Josh-Ramsey/EE463-Hardware-Project/Simulation_Report/ Block_Diagram.png

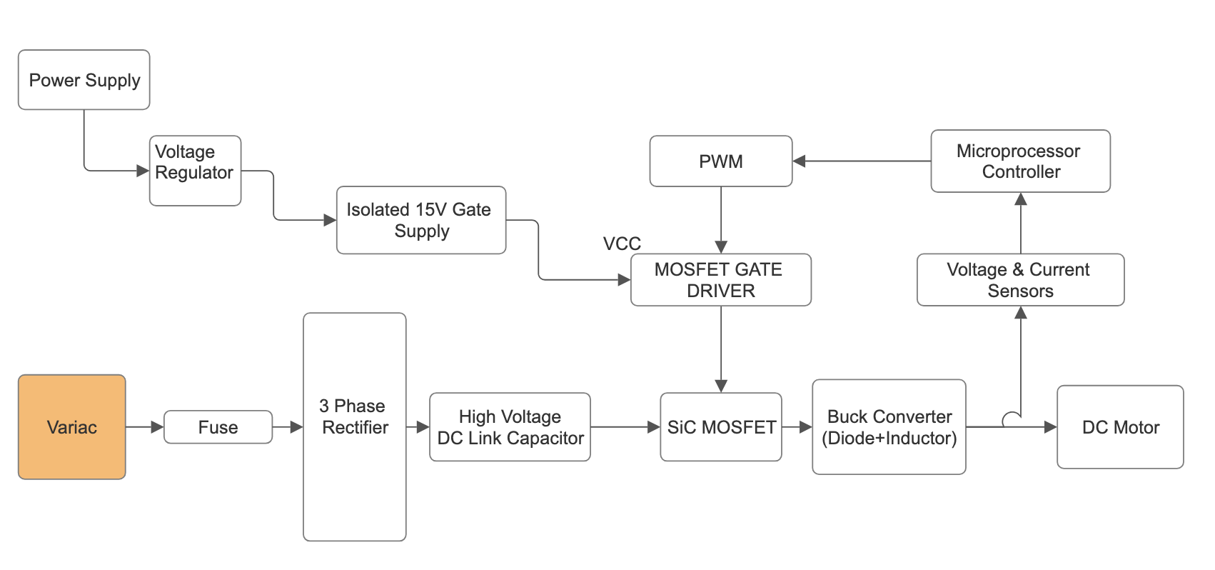
Simulation_Report/ Block_Diagram.png
