Josh-Ramsey/EE463-Hardware-Project/Simulation_Report/Circuit_Topology.jpeg

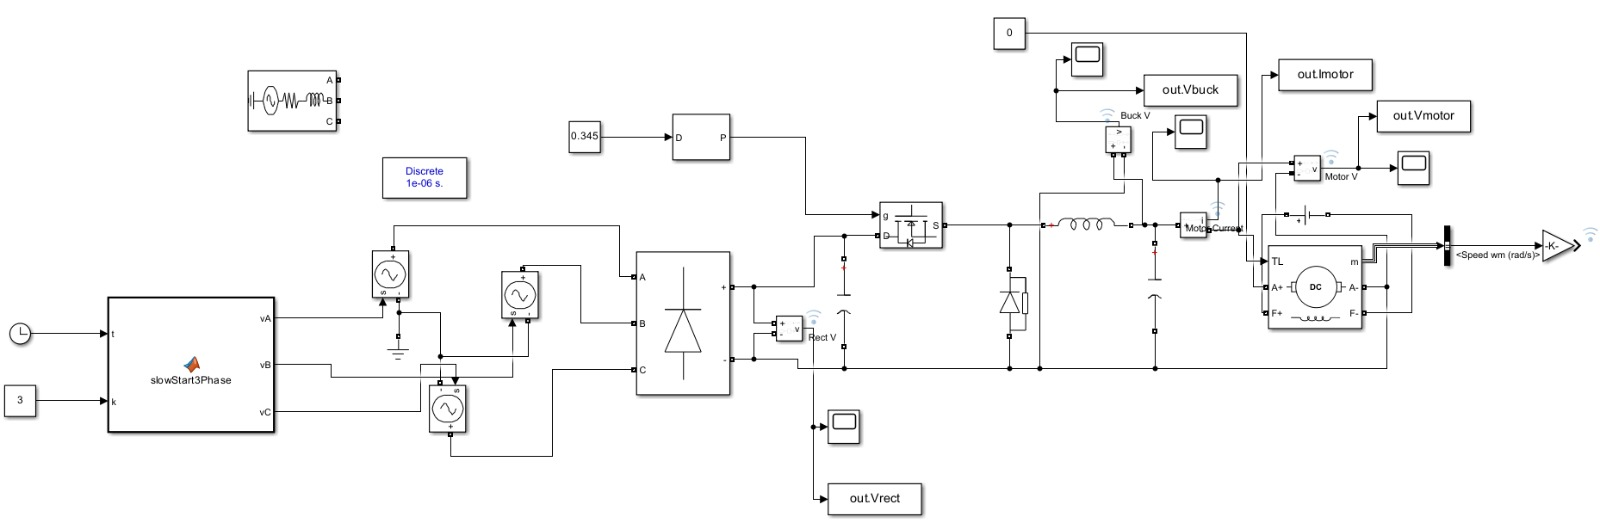
Simulation_Report/Circuit_Topology.jpeg
