Josh-Ramsey/EE463-Hardware-Project/Simulation_Report/Control_Loop_Block_Diagram.png

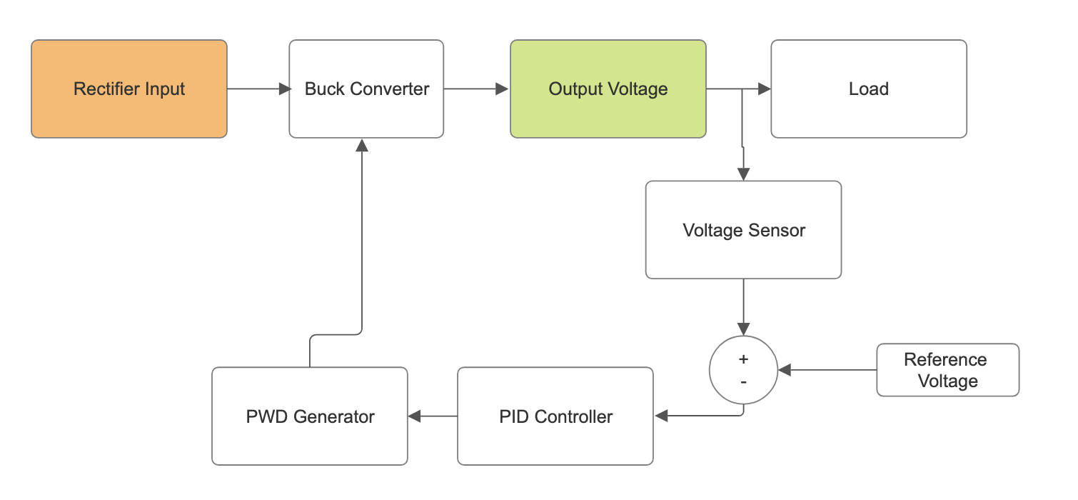
Simulation_Report/Control_Loop_Block_Diagram.png
