Josh-Ramsey/EE463-Hardware-Project/Simulation_Report/motor_current.png

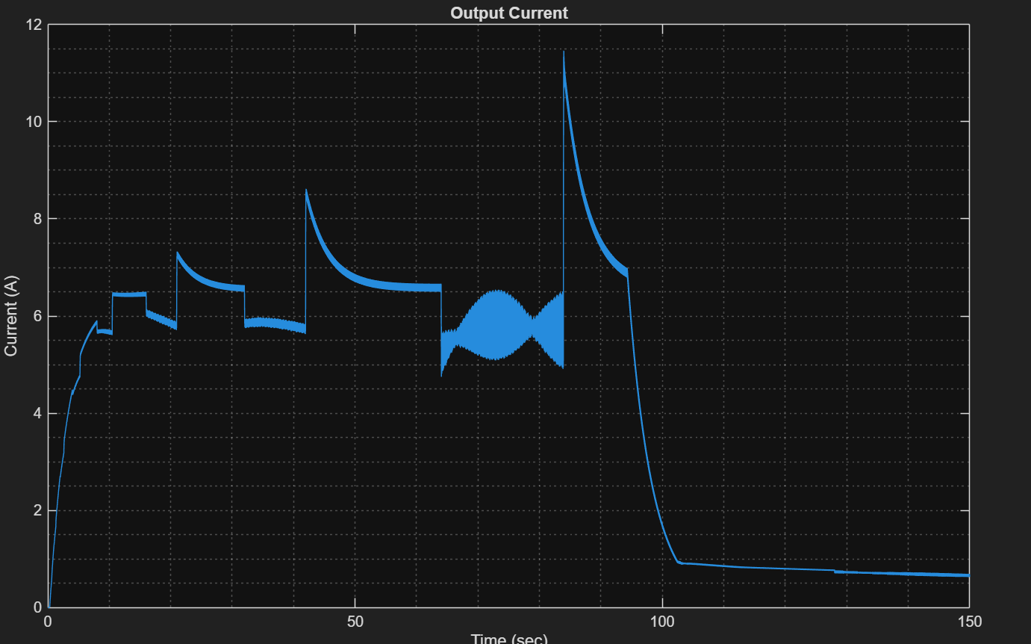
Simulation_Report/motor_current.png
