Josh-Ramsey/EE463-Hardware-Project/Simulation_Report/motor_voltage.png

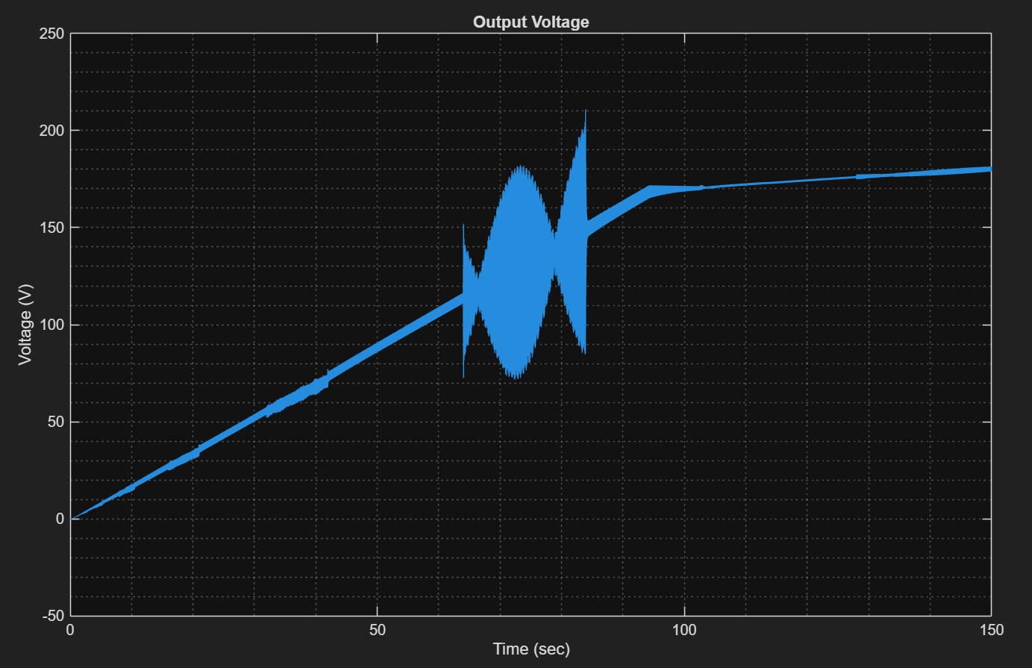
Simulation_Report/motor_voltage.png
