Josh-Ramsey/EE463-Hardware-Project/Simulation_Report/rect_voltage.png

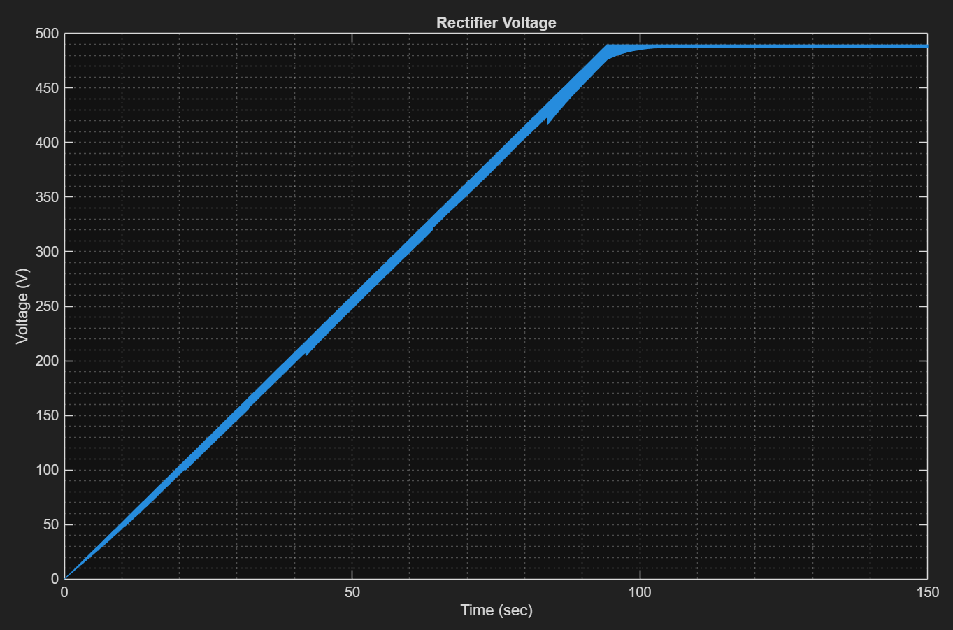
Simulation_Report/rect_voltage.png
