Josh-Ramsey/EE463-Hardware-Project/Circuit_Diagram.kicad_sch

## KiCad design Circuit_Diagram.kicad_sch (2025-12-30)

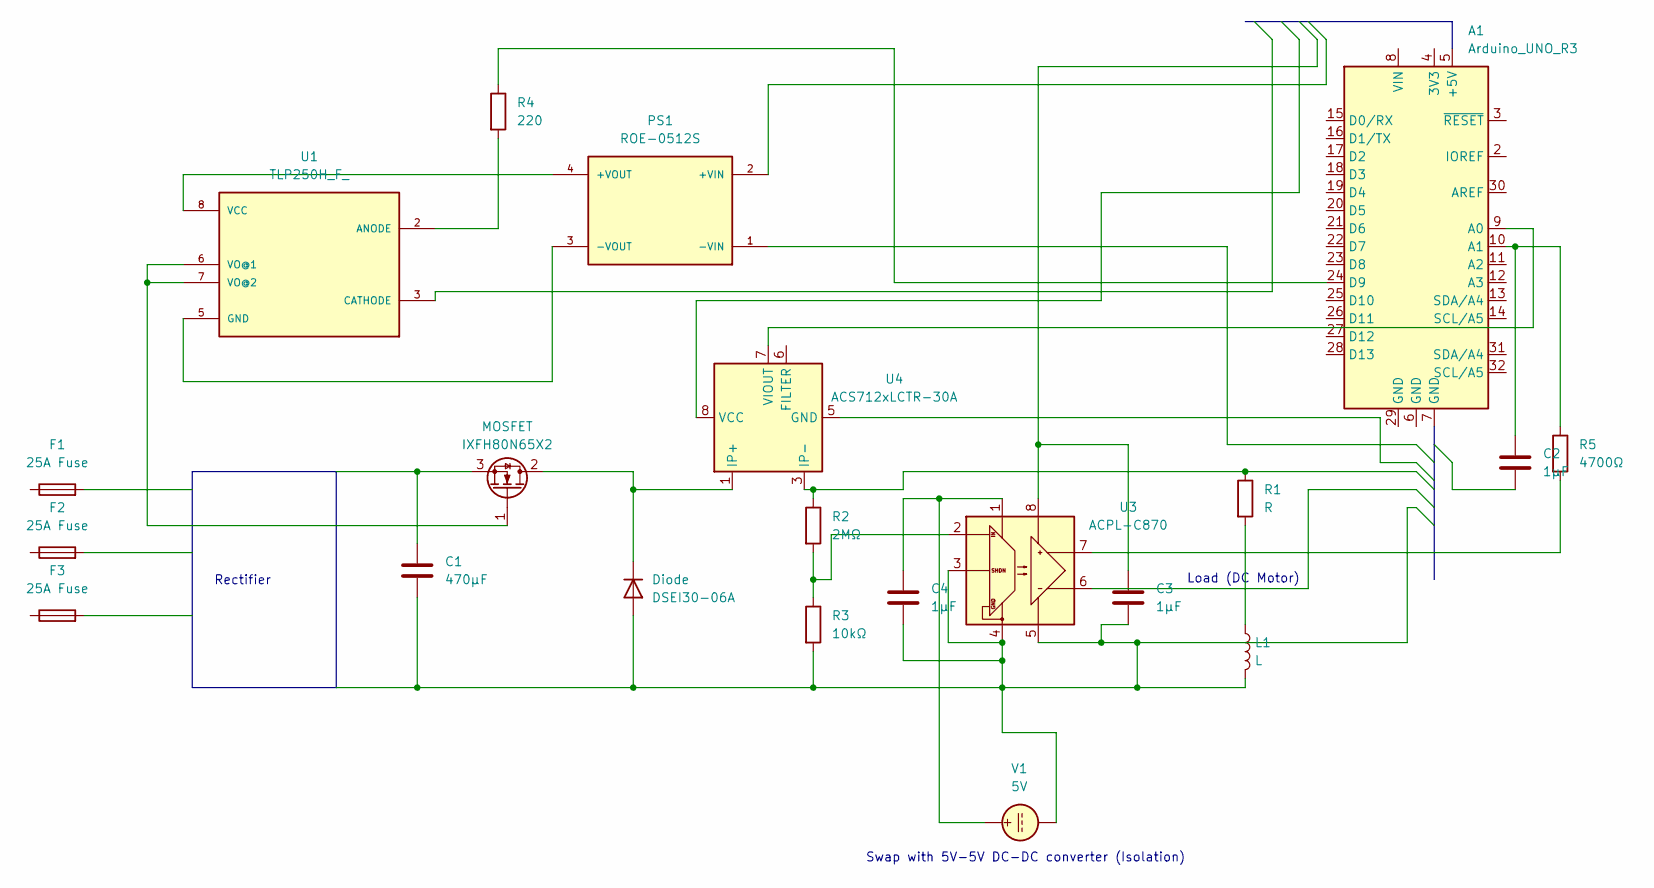
[picture p29: schematic Circuit_Diagram.kicad_sch]

Parts:
A1: Arduino_UNO_R3
C1: 470μF
C2, C3, C4: 1μF
Diode: DSEI30-06A
F1, F2, F3: 25A Fuse
L1: L
MOSFET: IXFH80N65X2
PS1: ROE-0512S; CONV_ROE-0512S; PARTREV 5
R1: R
R2: 2MΩ
R3: 10kΩ
R4: 220
R5: 4700Ω
U1: TLP250H_F_; DIP1016W50P254L966H380Q8P
U3: ACPL-C870; SSO-8_6.8x5.9mm_P1.27mm_Clearance8mm
U4: ACS712xLCTR-30A; SOIC-8_3.9x4.9mm_P1.27mm
V1: 5V

Connections:
unnamed: A1.9 (A0), U4.7 (VIOUT)
unnamed: A1.10 (A1), C2.1, R5.1
unnamed: A1.24 (D9), R4.1
unnamed: C1.1, MOSFET.3 (S)
unnamed: C1.2, C3.2, C4.2, Diode.2 (A), L1.2, R3.2, U3.3 (IN-), U3.4 (GND1), U3.5 (GND2), V1.2
unnamed: C3.1, U3.8 (VDD2)
unnamed: C4.1, U3.1 (VDD1), V1.1
unnamed: Diode.1 (K), MOSFET.2 (D), U4.1 (IP+), U4.2 (IP+)
unnamed: L1.1, R1.2
unnamed: MOSFET.1 (G), U1.6 (VO@1), U1.7 (VO@2)
unnamed: PS1.3 (-VOUT), U1.5 (GND)
unnamed: PS1.4 (+VOUT), U1.8 (VCC)
unnamed: R1.1, R2.1, U4.3 (IP-), U4.4 (IP-)
unnamed: R2.2, R3.1, U3.2 (IN)
unnamed: R4.2, U1.2 (ANODE)
unnamed: R5.2, U3.7 (OUT+)

Notes on the sheet:
Rectifier
Load (DC Motor)
Swap with 5V-5V DC-DC converter (Isolation)
