Josh-Ramsey/EE463-Hardware-Project/(commit log)

2025-12-02 Updated Basic Model of Rectifier+Buck Converter with Resistive Load.
2025-12-02 Updated basic model. Rectifier and Buck converter giving desired outputs
2025-12-05 Circuit Topology uploaded
2025-12-05 Basic Voltage Control Loop Block Diagram Created
2025-12-08 Working Open Loop Model for Rectifier+Buck Converter. Load Simulated
    Component values open to change
2025-12-29 Circuit diagram for Converter+Control Loops
    [Circuit_Diagram.kicad_sch]
2025-12-29 Initial deisgn of Arduino control in simulink. Needs tuning with physcial testing
2025-12-30 Updated wiring diagram
    Added RC filter to voltage sensor output
    [Circuit_Diagram.kicad_sch]
2025-12-30 Updated Schematic
    Replaced HCPL3120 DIP-8 with TLP250 DIP-8
    [Circuit_Diagram.kicad_sch]
2026-01-09 Basic Simulink file to determine if Arduino can control circuit
2026-01-09 Control Dashboard for Arduino PWM control. Includes Soft Start button, slider to control speed, and soft stop button
2026-01-10 Changed simulation parameters to not overload Arduino processor
2026-01-11 New arduino controlled Motor Driver for demonstration day
2026-01-17 Circuit Diagram
